tonybibliophile/RocketCup-avionic-board-project/simulation_and_data/flight_plots/ekf_3d_trajectory.png

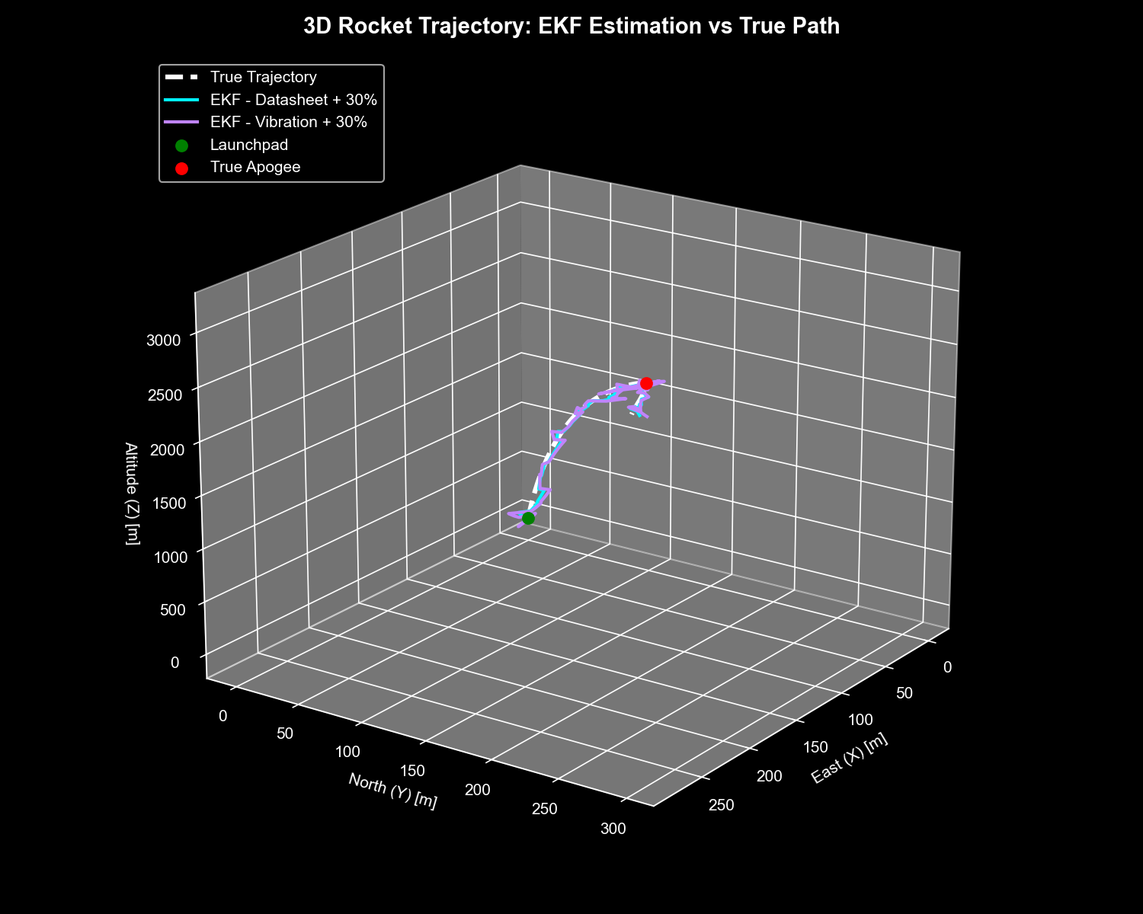
simulation_and_data/flight_plots/ekf_3d_trajectory.png
