tonybibliophile/RocketCup-avionic-board-project/simulation_and_data/flight_plots/ekf_errors.png

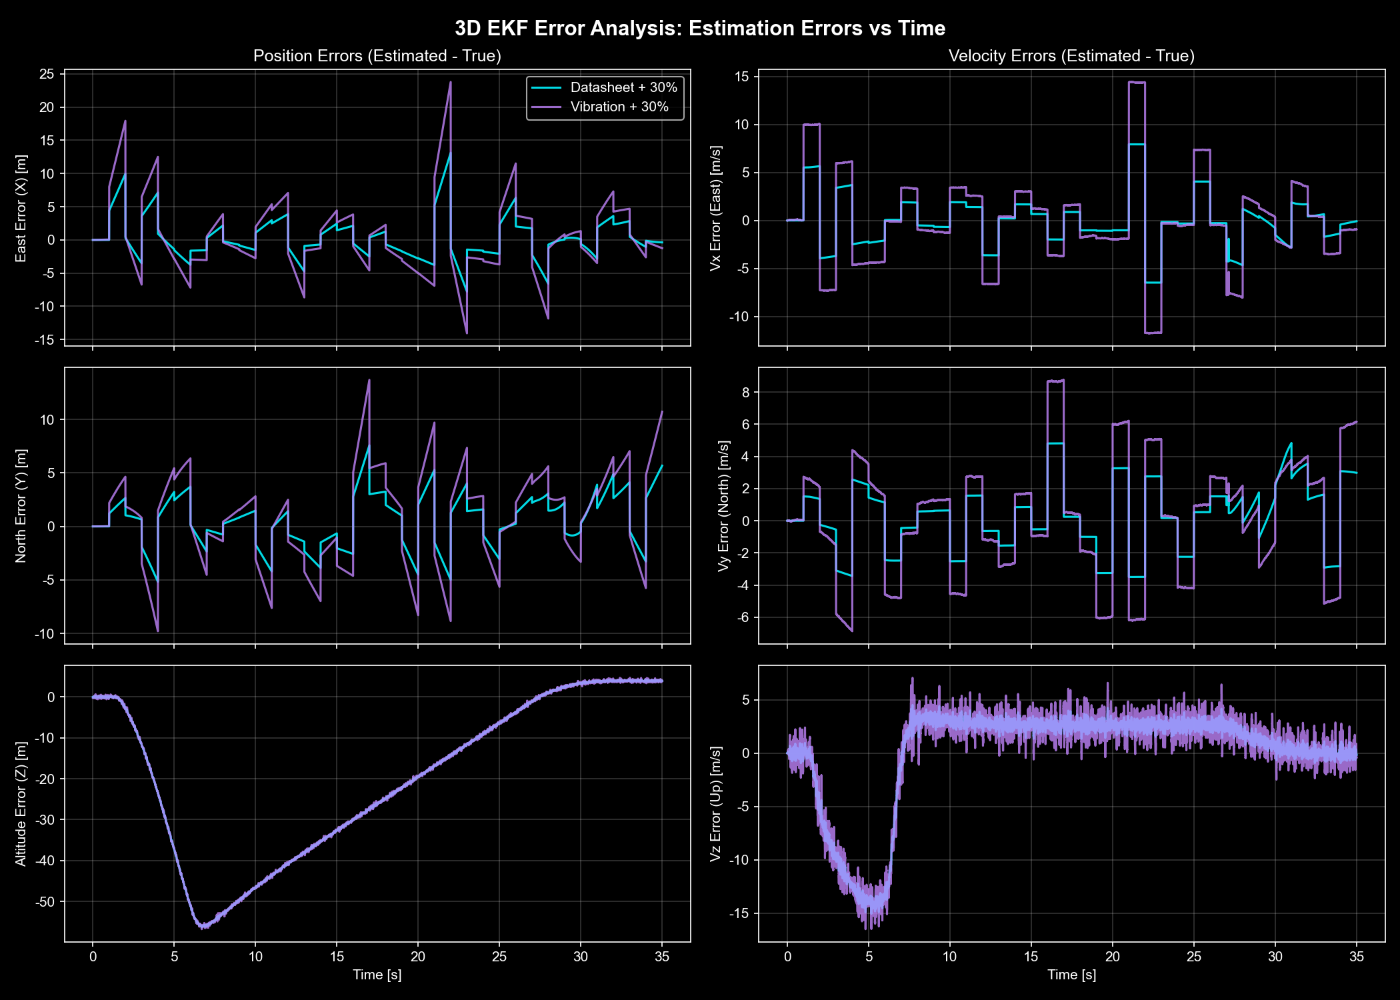
simulation_and_data/flight_plots/ekf_errors.png
