tonybibliophile/RocketCup-avionic-board-project/simulation_and_data/flight_plots/flight_record_20260713_161340.png

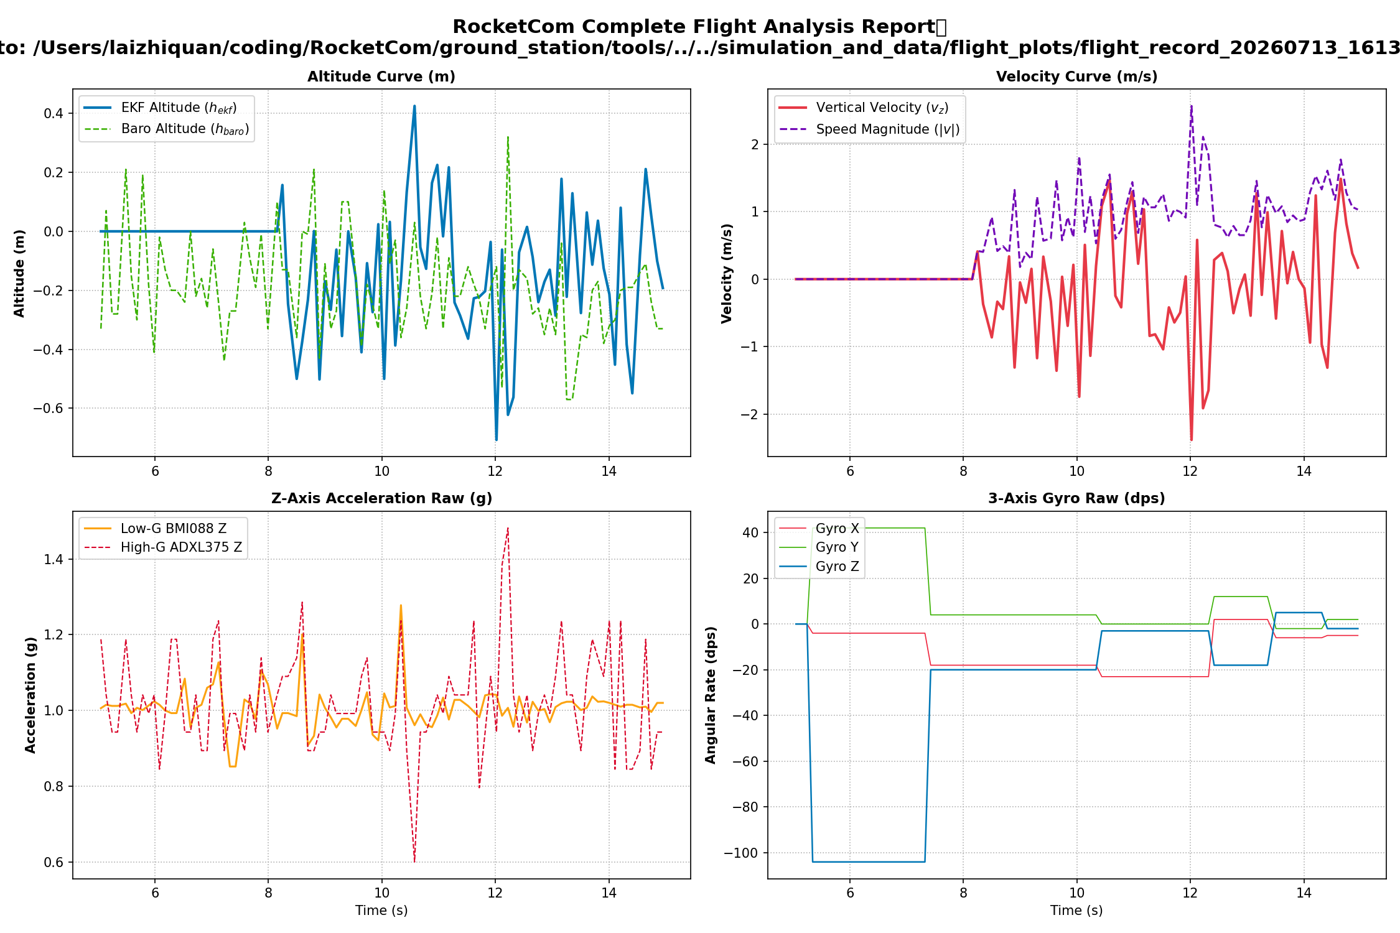
simulation_and_data/flight_plots/flight_record_20260713_161340.png
