tonybibliophile/RocketCup-avionic-board-project/simulation_and_data/flight_plots/flight_record_20260713_211612.png

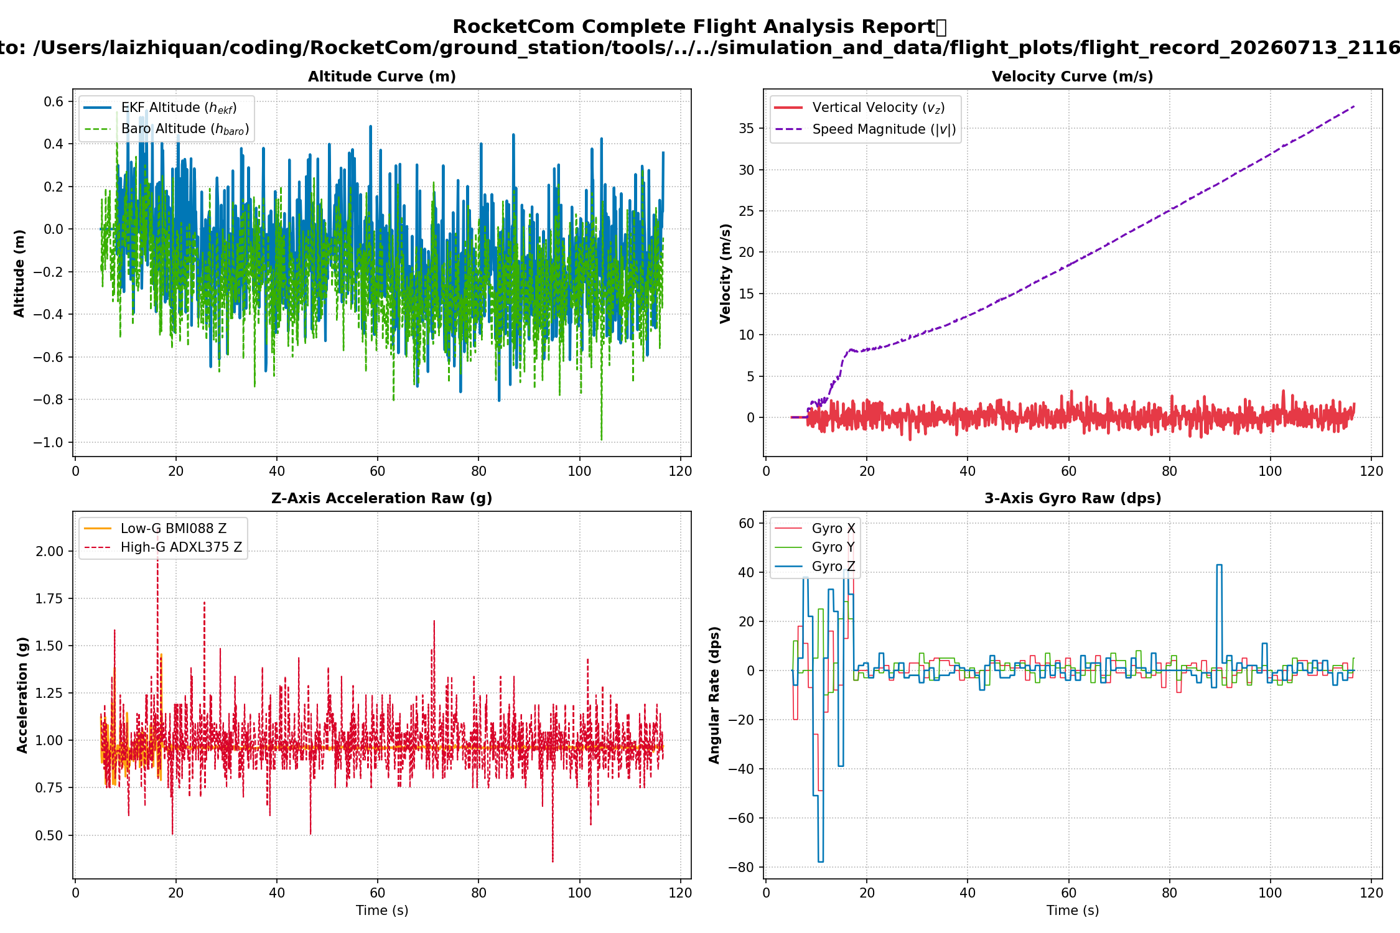
simulation_and_data/flight_plots/flight_record_20260713_211612.png
