tonybibliophile/RocketCup-avionic-board-project/simulation_and_data/flight_plots/flight_record_20260724_224327.png

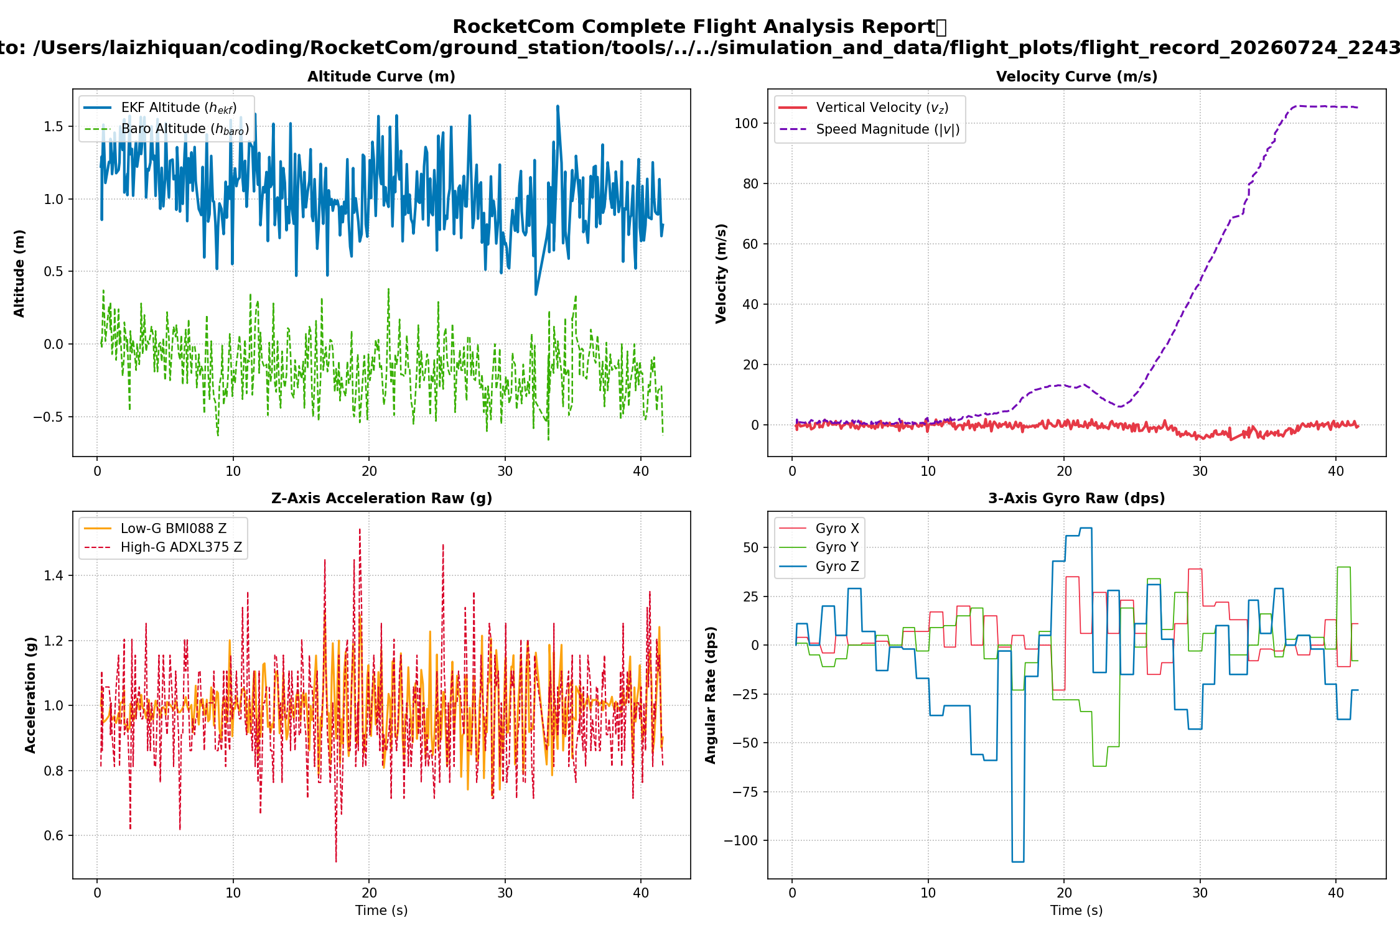
simulation_and_data/flight_plots/flight_record_20260724_224327.png
