tonybibliophile/RocketCup-avionic-board-project/hardware/avionic_bay/CAD/lid.SLDPRT

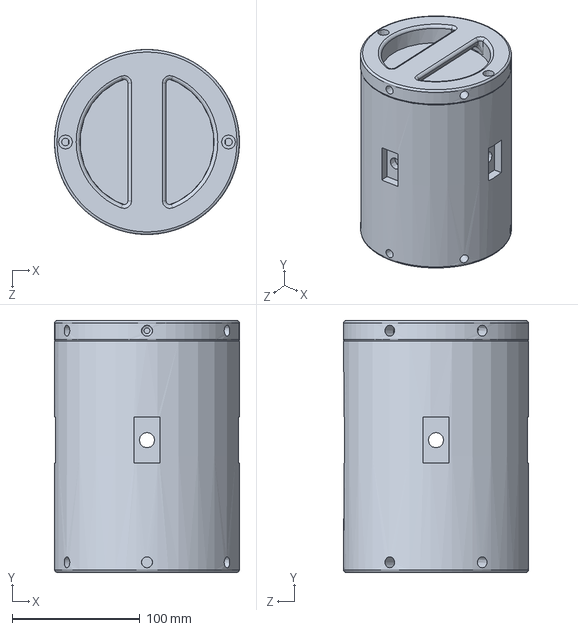
[picture p21: CAD file, 2026-07-31]
hardware/avionic_bay/CAD/lid.SLDPRT
145.0 x 197.5 x 145.0 mm
