tonybibliophile/RocketCup-avionic-board-project/hardware/avionic_bay/CAD/火箭簡版模型.STL

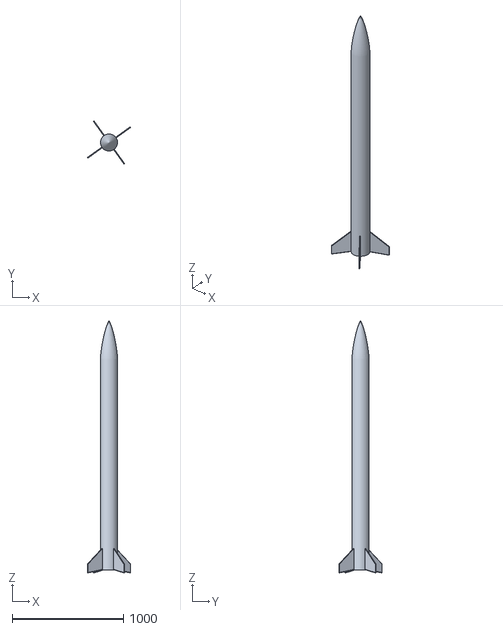
[picture p22: CAD file, 2026-07-31]
hardware/avionic_bay/CAD/火箭簡版模型.STL
390.1 x 390.1 x 2268.3
