tonybibliophile/RocketCup-avionic-board-project/(commit log)

2026-07-28 fix(mag): 磁力計 CMM 校正修正 + 地面站 GUI 全面重構 + 伺服互斥/EKF/FSM 收斂
    - 主/備雙航電對稱冗餘收尾：servo_arb 舵機互斥握手、link/link_proto 板間鏈路強化
    - EKF/FSM/vertical_filter 多項修正（起飛判定改吃 BMI088、EKF guard 收斂）
    - LoRa E22/E80 傳輸與 RSSI 子封包問題修正、上行指令(uplink_cmd)強化
    - 新增 IMU 原始資料記錄（imu_raw_log）與對應 host 測試
    - 地面站 GUI 重構為 GUI_avionic.py + gui_theme.py，新增磁力計校正、感測器誤差
    與地面站分析工具
    - 新增/擴充 host 單元測試（FSM elevator/noise/stress、servo_arb、imu_raw_log、
    OpenRocket 對照），全數通過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
    [GUI_avionic.py, adxl375.c, bmi088.c, bmp388.c, bmp388.h, board_config.h]
2026-07-28 fix(ground_station_analyzer): 同步 433 LORA433_TX_EVERY=1 與新增上行接收窗常數
    分析工具的鏡像常數跟 firmware（main.c，同一次 commit 404d4ff）已不同步：
    LORA433_TX_EVERY 從 3 改 1 後，calc_seq_loss() 的 step 正規化被除小、
    lost 貼地板成 0，433 單鏈路真丟包會被完全吃掉測不出來（假陰性，比原本
    要防的「合法降速誤判成丟包」更危險）。同時補上 UPLINK_LISTEN_EVERY=10
    上行接收窗造成的規律 seq 間隙修正，以及以空中時間物理上限重算的 433
    NOMINAL_RATE_HZ（≈2.33Hz，取代舊的時槽除數公式≈3.33Hz）。
    [ground_station_analyzer.py]
2026-07-28 fix(ground_station_analyzer): 修正 Union Loss / 單鏈路丟包率的 seq 排序 aliasing bug
    四次實測 report 都顯示「合併到達率丟失」96~99% FAIL，換算隱含 tick 頻率高達
    ~270~370Hz，遠超火箭端 10Hz 設計上限，數學上不可能成立。根因是 calc_seq_loss()
    把事件按到達時間排序後直接取 (seq[i]-seq[i-1]) % 256——隱含假設按到達時間排序
    seq 必然遞增。433 空中時間(~387ms)遠長於 920(~87ms)，合併雙鏈路時只要一次 433
    包比 920 晚到、造成正常的時間序倒置，就會被 mod 256 誤讀成 seq 跳了近 256，
    單一次誤判即可讓 expected 暴衝。
    改用 unwrap_seq_to_ticks()：依已知的固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
    [ground_station_analyzer.py]
2026-07-28 fix(ground_station_analyzer): calc_tick_loss 改逐 tick 檢查 seq 是否漏收
    前一版用「範圍大小(span) - 收到幾個相異 tick」的整體統計反推丟包數，
    UPLINK_LISTEN_EVERY 上行接收窗則用平均折讓(expected -= expected/N)近似扣除。
    這在樣本數少時（例如 10 秒內只收到十幾筆的短擷取）容易失真，而且不是真的
    「看每一筆 seq 判斷是否漏掉」。
    改為直接逐 tick 走訪涵蓋範圍：對每個依 step 對齊的候選 tick，先用跟韌體
    main.c listen_slot 判斷式完全相同的條件(tick % UPLINK_LISTEN_EVERY ==
    UPLINK_LISTEN_EVERY-1)排除已知的上行窗，再檢查該 tick 是否真的出現在實收
    集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
    [ground_station_analyzer.py]
2026-07-28 fix(ground_station_analyzer): 序列埠 read timeout 0.5s 太大污染紀錄管線 gap 統計
    即時連線模式下觀察到「封包落地間隔」統計值幾乎只在 0ms/500ms 兩極跳動。根因
    是 serial_link.open_serial() 的 pyserial timeout 設 0.5s：ser.read(4096) 在
    這個 baud/印出速率下幾乎不可能在 500ms 內湊滿 4096 bytes，於是每次呼叫都卡滿
    整整 500ms 才把這段時間內累積的所有 console 行一次吐出——同批內的行被
    time.time() 蓋上幾乎相同的時間戳(gap≈0ms)，批與批之間則卡在那顆 500ms
    timeout 上(gap≈500ms)。量到的是 PC 端讀序列埠的輪詢週期，不是真實封包到達
    間隔，也不是 SD/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
    [ground_station_analyzer.py]
2026-07-28 fix(ground_station_analyzer): 433 單鏈路丟包率誤用排程嘗試頻率當機會基準
    「單鏈路 RF 到達率丟失」的 step 沿用 SEQ_STEP[LINK_433]=LORA433_TX_EVERY(=1)，
    意思等於「假設 433 每個 100ms tick 都該收到一筆」。但 433 單包空中時間
    (2400bps/116B ≈386.7ms)跨了近 4 個 tick，LoRaE22_Send() 遇 AUX busy 只會
    直接跳過、不等待，物理上兩次成功發射之間最少要間隔 ceil(386.7/100)=4 個
    tick——即使 RF 訊號完全乾淨無雜訊，也不可能達到「每 tick 都收到」，導致這項
    檢查即使 CRC 0% 錯誤、RSSI 正常，仍常態性回報 80%+ 假丟包。
    新增 LORA433_MIN_TX_SPACING_TICKS(=4)，SEQ_STEP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
    [ground_station_analyzer.py]
2026-07-28 refactor(ground_station_analyzer): 單鏈路丟包率改用純 seq 展開，不靠時間反推
    單鏈路檢查本來就不會有跨鏈路重排問題（同一鏈路收到的順序即真實傳送順序，
    韌體單執行緒同步解碼+印出，不會重排）——之前借用合併檢查那套「靠 wall-clock
    時間反推 tick」的 unwrap_seq_to_ticks() 對單鏈路來說是不必要的間接依賴。
    新增 unwrap_seq_sequential()：純粹用相鄰兩筆 seq 的 mod 256 差值累加展開，
    完全不吃 host 端時間戳，量測結果不受序列埠讀取時序/緩衝延遲影響。合併雙鏈路
    的 Union Loss 檢查仍用時間版 unwrap_seq_to_ticks()（那裡才有真正的跨鏈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
2026-07-29 fix(ground_station_analyzer): 433 空中時間估計值改用較保守數字，並標註非實測
    上一輪討論發現韌體裡對「116 bytes @ 2.4k 空中時間」有兩份互相矛盾的估計：
    main.c 用純位元數/鮑率算出 ~386.7ms，lora_e22.c 另一處給的是 ~580ms。查
    E22-400T30S 規格書證實這顆模組底層是 LoRa 調變(SX1262)，「air data rate」
    只是展頻參數的抽象標籤，不是序列埠那種純位元速率——跟 920(E80/LR1121) 一樣，
    真實空中時間還要疊加前導碼/表頭等 LoRa 開銷，386.7ms 那個純位元數/鮑率算法
    幾乎必然低估，這正是分析工具算出的「韌體應有頻率」一直比實測頻率樂觀的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
    [ground_station_analyzer.py]
2026-07-29 refactor(ground_station_analyzer): 丟包率改用封包間隔(gap)判斷，不再反推發送機會分母
    433 的丟包率需要先假設火箭端本來該發幾包，但空中時間/AUX背壓/上行接收窗相位都是
    未實測值，分母本身是猜的（歷次 report 甚至換算出遠超硬體上限的隱含 tick 頻率）。
    改用只依賴「實際收到什麼」的量測值：有效/總通訊頻率、平均與最長封包間隔（單鏈路+
    雙鏈路合併），門檻依名目速率換算。同步移除舊的 calc_tick_loss/unwrap_seq_*/SEQ_STEP/
    UPLINK_LISTEN_EVERY，並將上行接收窗模型從「每10槽跳1槽」改成「每3000ms連續800ms
    不發」以配合韌體實際排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
2026-07-31 chore(gitignore): 忽略地面站工具產出目錄 logs/ reports/ runs/
    三個目錄都是工具執行時自動產生、可由原始資料重新生成的產出，不該進版控：
    - ground_station/logs/ 412MB（gui_serial_continuous 串列 log 單檔就 20~28MB，
    外加 realtime_charts 的 chart PNG，共 562 個檔）
    - ground_station/reports/ 8.9MB（ground_station_analyzer 每跑一次就新增
    html/json/md 三份）
    - ground_station/runs/ 15MB（gps_live_analyzer 每場側錄一個目錄）
    runs/ 過去有 8 個檔案已進版控，一併 git rm --cached 取消追蹤（檔案留在工作區）。
2026-07-31 assets(CAD): 新增 lid.SLDPRT 與火箭簡版模型.STL
    兩個檔原本散落在 repo 根目錄，移進 hardware/avionic_bay/CAD/ 與其餘 CAD 檔放一起。
    lid.SLDPRT 與既有的 lid_v8.SLDPRT 是不同檔案，未覆蓋任何已追蹤檔案。
    [lid.SLDPRT, 火箭簡版模型.STL]
2026-07-31 feat(firmware): 下鏈封包重整、主傘雙板共開、主/副開傘時序分流、433 上行接收窗修正
    工作區累積數週未提交，且各主題在 telemetry.h / fsm.h / board_config.h / main.c
    內互相交錯（例如舊 main.c 直接引用被移除的 pkt.baro_press_pa 與已廢除的
    SERVO_ARB_MSG_DRIVING），無法在檔案粒度上拆成各自可編譯的 commit，故合併提交。
    主要內容如下：
    ■ 下行封包重整（telemetry.h，封包大小再變 → ★三塊板都必須重燒）
    移除：baro_press_pa（與 baro_alt_cm 冗餘）、cpu_ekf_x10、高G 三軸、磁力計三軸、
    對端 EKF 高度/速度、對端丟包率、對端高G。對端一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
    [board_config.h, ekf.c, ekf.h, flash_ring_math.h, fsm.c, fsm.h, gps_parse.h, ground_station.c]
2026-07-31 feat(ground_station): 對齊新下鏈封包、電梯 profile 醒目警示、地圖/3D 姿態元件抽出
    配合上一個 commit 的韌體封包重整（★兩者必須同時上板/更新，封包長度已變）。
    ■ 解碼對齊（telemetry_decoder.py 及三支 GUI）
    移除 baro_press_pa、cpu_ekf_x10、磁力計三軸、對端 EKF 高度/速度、對端丟包率、
    對端高G 的解析；高G 改讀單一模長。新增滾動極值（max_alt/max_vel/max_acc）與
    實際開傘高度（drogue_alt/main_alt）欄位與對應儀表卡片。極值/開傘高度的文字行
    解析整段設為可選 regex，舊韌體沒有這些 token 時仍能解析，缺值時卡片維持 "--"
    而非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
2026-07-31 feat(firmware): flash 池未達標主動警示 + `flash pool` 快速填池指令
    開機序列已不再自動擦除（見前一 commit 的熱重啟/預擦改動），因此「該擦而沒擦」
    不會有任何自然徵兆——使用者只會在按下 ARM 被擋時才發現。補上三個提醒管道：
    · main.c 1Hz 橫幅 [FLASH_NOT_READY]：僅在地面狀態（INIT/PAD/PAD_ARMED）印，
    飛行熱路徑不印（printf 會拖慢主迴圈）。旗標每輪重算，擦完自動消失。
    fail-open 條件與 FSM_Update 組 flash_pool_ready 時一致：flash 沒偵測到或
    已停止記錄時不擋 ARM，也就不再喊「需要擦除」。
    · 下鏈 arm_flags 新增 TELEM_ARM_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
    [main.c, telemetry.c, telemetry.h]
2026-07-31 feat(ground_station): 解碼 arm_flags 的 TELEM_ARM_NEED_ERASE 位
    對應前一個 commit 的韌體改動：航電開機不再自動擦除 flash，此位在使用者按 ARM
    「之前」就先亮，提示先下 `flash erase`（整環，飛前正規流程）或 `flash pool`
    （只補不足部分）。
    fmt_human 用 elif 而非另起一行：bit0（已按 ARM 被擋）比 bit1（尚未按的預先警告）
    更急迫，兩位同時亮時只顯示 bit0，避免同一件事洗兩行。
2026-07-31 assets(flight_plots): 新增 2026-07-29 兩筆飛行紀錄圖
    沿用 simulation_and_data/flight_plots/ 既有慣例（該目錄已追蹤 28 個同類 plot）。
2026-07-31 feat(ground_station): Flash 未擦除頂欄橫幅（gui_theme 共用）
    對應韌體 TELEM_ARM_NEED_ERASE：航電開機不再自動擦除，「該擦而沒擦」在地面站端
    沒有任何自然徵兆，操作員只會在按下 ARM 被擋時才發現。橫幅與電梯 profile 橫幅
    共用同一套顯示/閃爍機制（含 winfo_manager() 而非 winfo_ismapped() 的判斷）。
2026-07-31 feat(flash 警示): [GS_PKT] 帶出 armf 位並在 gui_monitor 顯示未擦除橫幅
    補完 TELEM_ARM_NEED_ERASE 的最後一段鏈路——先前韌體已設好該位、gui_theme 已備好
    橫幅元件，但地面站板的 [GS_PKT] 文字行沒有把 arm_flags 印出來，GUI 端拿不到值。
    · ground_station.c：[GS_PKT] 尾端新增 armf:0x%02X。純字串尾端加欄位，舊解析器
    match 不到就略過，封包結構未動 ⇒ 這一項不需三板同燒。
    · gui_monitor.py：兩個來源共用同一組狀態——直連航電的 [FLASH_NOT_READY] 1Hz 行
    （順便解析池的實際格數顯示在橫幅上），與經地面站板中繼的 [GS_PKT] armf 位。
    新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
2026-07-31 fix(firmware): flash 指令自 PAD_ARMED 允許清單移除
    擦除/匯出全程阻塞 defaultTask（整環全擦 ~3min、填池最壞 1500×400ms、
    export 數秒），期間 FSM_Update 不跑，起飛偵測與開傘邏輯完全停擺——而
    STATE_PAD_ARMED 的定義正是「隨時可能起飛」。
    g_flash_erase_in_progress 只擋「新的 ARM 生效」，不會解除既有武裝，所以
    先前允許 PAD_ARMED 的那條路徑是真的會在已武裝狀態下卡死主迴圈數分鐘。
    改為僅 INIT/PAD/LANDED 受理，並在拒絕訊息中指明處置（先 DISARM）。
    本閘同時涵蓋 flash erase / pool / dump / export。
    [main.c]
2026-07-31 test(flash_ring): 池容量納入武裝期消耗與熱重啟窗口
    原本只驗「池 >= 飛行段看門狗視窗」，漏掉兩件事：
    1. PAD_ARMED 以 1Hz 寫入且該段禁止同步擦除、背景 PreEraseOne 只在
    state <= STATE_PAD 才跑，池在武裝期只出不進。新增「扣掉 30 分鐘
    武裝後仍覆蓋看門狗視窗」。
    2. 卡在飛行狀態的板子要能靠「通電放久、flight_tick_ms 增長超過
    FSM_HOTSTART_MAX_TICK_MS」老化出熱重啟窗口；但寫入會在池耗盡時停止、
    把 flight_tick_ms 凍住，若凍結值 <= 窗口就會每次重開機都熱重啟回同一
    狀態，永遠出不來。新增「池的時間容量 > FSM_HOTSTART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
2026-07-31 feat(ground_station): GUI_avionic 也顯示 flash 未擦除橫幅
    航電開機不再自動擦除，池未達標時 ARM 會被擋；GUI_avionic 是直連 USB 的
    操作台，[FLASH_NOT_READY] 1Hz 行直接進得來，卻沒有對應橫幅——操作員只會
    在按下 ARM 被擋時才發現。沿用 gui_theme 的共用橫幅（與 gui_monitor 同一套
    閃爍/顯示機制），5 秒新鮮度窗口，擦完自動消失。
2026-07-31 feat(flash): 擦除進度即時回報 + 填池改用 block erase + 擦除期間只留 LoRa
    三個問題一起處理（使用者回報：erase 沒顯示進度、太慢、應暫停其他任務）。
    1) 進度：FlashRing_EraseAll() 過去整段 3 分鐘只每 32 塊印一行純文字，且完全
    不更新 s_ring_erase_pct，板間鏈路/GUI 的進度一路停在 0，看起來像當機。
    現在每塊更新 pct、接受 progress_cb（與預擦/填池共用 FlashErase_ProgressCallback，
    自 FlashPreErase_ProgressCallback 更名），文字進度改每 16 塊一行並附
    「本塊耗時 / 平均 / 已用 / 預估剩餘」——這三個數字才能回答「為什麼慢」：
    64KB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
2026-07-31 feat(flash+link): 開機自動補池、跨板 erase 中繼、手動開傘命令中繼
    Flash 擦除政策再迭代（接續前一版即時進度回報）：
    - 開機序列改為自動 TopUpPool 補到 FLASH_RING_PREERASE_TARGET，取消「使用者
    必須手動 flash erase 才能 ARM」的政策；連帶移除 ARM 防護閘與三支 GUI 的
    「flash 未擦除」警告橫幅（協定位元保留，僅不再設定，不需三板同燒）。
    - 修 FlashRing_ProbePoolNoErase 探測迴圈的位元組/格數 off-by-one：寫入頭落在
    sector 中間時舊版永遠卡在 TARGET-1 格，明明整環可用卻誤報未達標。
    - 修 PAD_ARMED 期間即時池消耗導致「擦完一按 ARM 又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
2026-08-01 feat(fsm+uplink): 起飛門檻 30m、pad_ref 延伸到武裝期、未 ARM 加大上行接收窗
    飛行正式版本設定（FLIGHT_PROFILE_ELEVATOR=0、FEATURE_FLASH_BOOT_FULL_ERASE=0）。
    FSM 起飛門檻（fsm.h，飛行 profile）
    - FSM_LIFTOFF_BARO_ALT_M 20m→30m、FSM_LIFTOFF_ALT_M 10m→30m，並把後者改成
    依 profile 分組（電梯維持 10m，井道僅 ~30m，提高等同停用該路徑）。
    - 理由：FEATURE_FORCE_BARO_ONLY 已固定 0，h_est 由 VF 輸出而 VF 由 baro 帶動，
    兩條路徑物理量相同 → 舊組合的實質門檻只有 10m（≈1.2 hPa），台上組裝/搬運
    就可能吃掉。同步提到 30m 後需 ~3.6 hPa 等效變化才誤觸發；真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
2026-08-01 fix(ground_station): macOS 圖表後端改優先 TkAgg、USB 自動直連、放寬桌測門檻
    - matplotlib 後端在 darwin 改先試 TkAgg 再退 MacOSX（MacOSX backend 在
    非主執行緒的即時更新會卡住/崩潰），兩支 analyzer 一致。
    - file_selector：Tk filetypes 的多副檔名要用 tuple，分號字串在 macOS 上
    會讓「Supported RocketCom Files」整組篩不到檔。
    - sensor_error_analyzer：無 --file/--port 時先探測實體 USB 航電板，找到就
    直接進 USB 即時監測，找不到才跳檔案選擇器。
    - 桌測誤報收斂：bmi088 gyro RMS 0.30→0.60 dps、mmc5983 雜訊 5→100 mG，
    433 TX 成功率門檻 0.95→0.30 且降為 WARN（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
    [file_selector.py, ground_station_analyzer.py, sensor_error_analyzer.py]
